joranvg/test-3/hardware/test-3-pcb.pdf

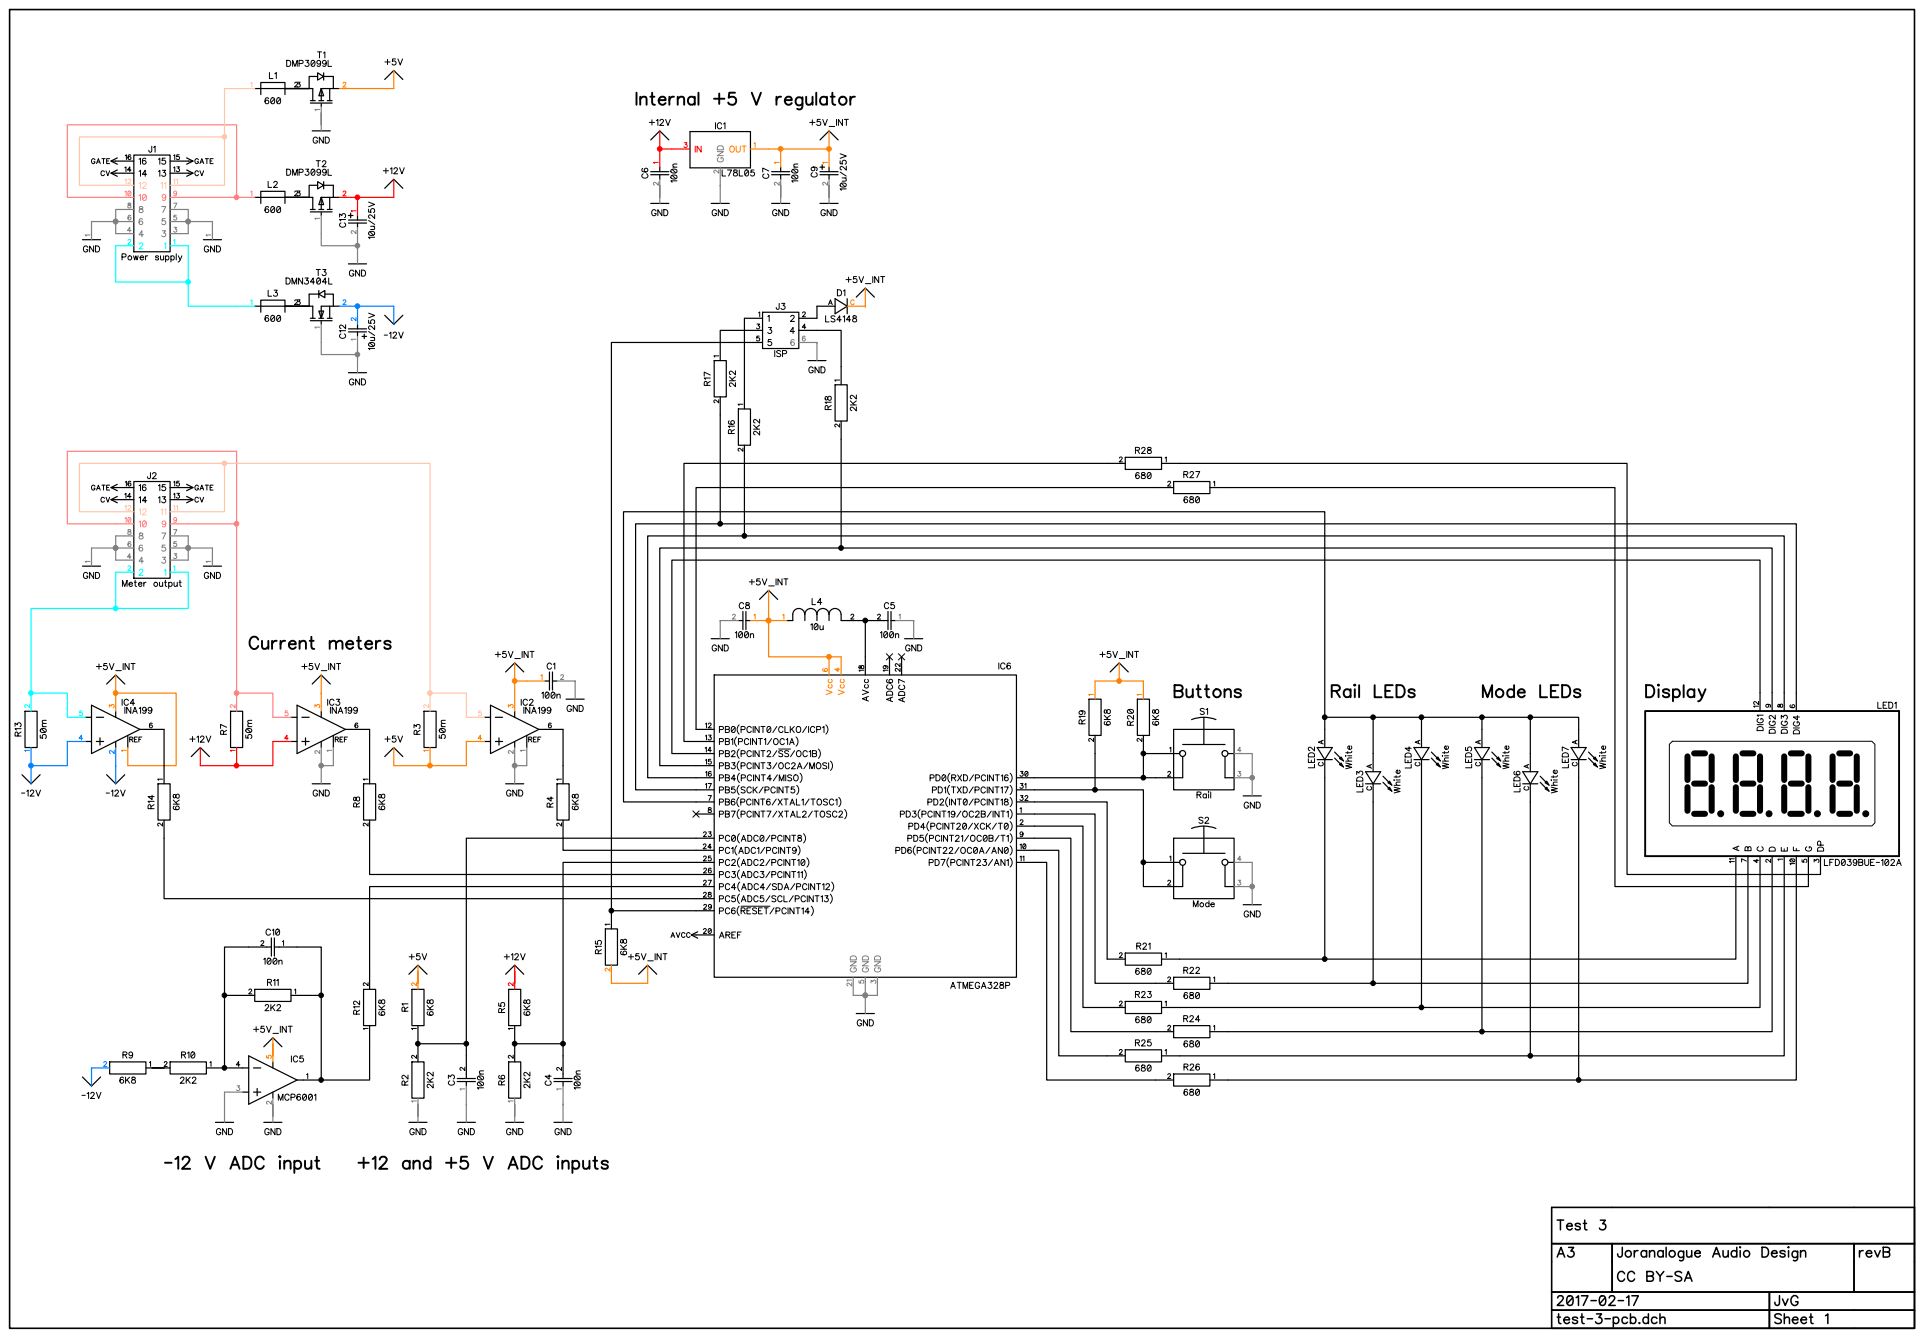
[picture p5: page 1]
