joranvg/test-3/(list of files, drawings)

Other design files:
hardware/test-3-pcb.dch
